jean-claudeF/LiIonCapacityMeter/KiCAD/capacity_meter_01.sch

## KiCad design KiCAD/capacity_meter_01.sch (2024-09-06)

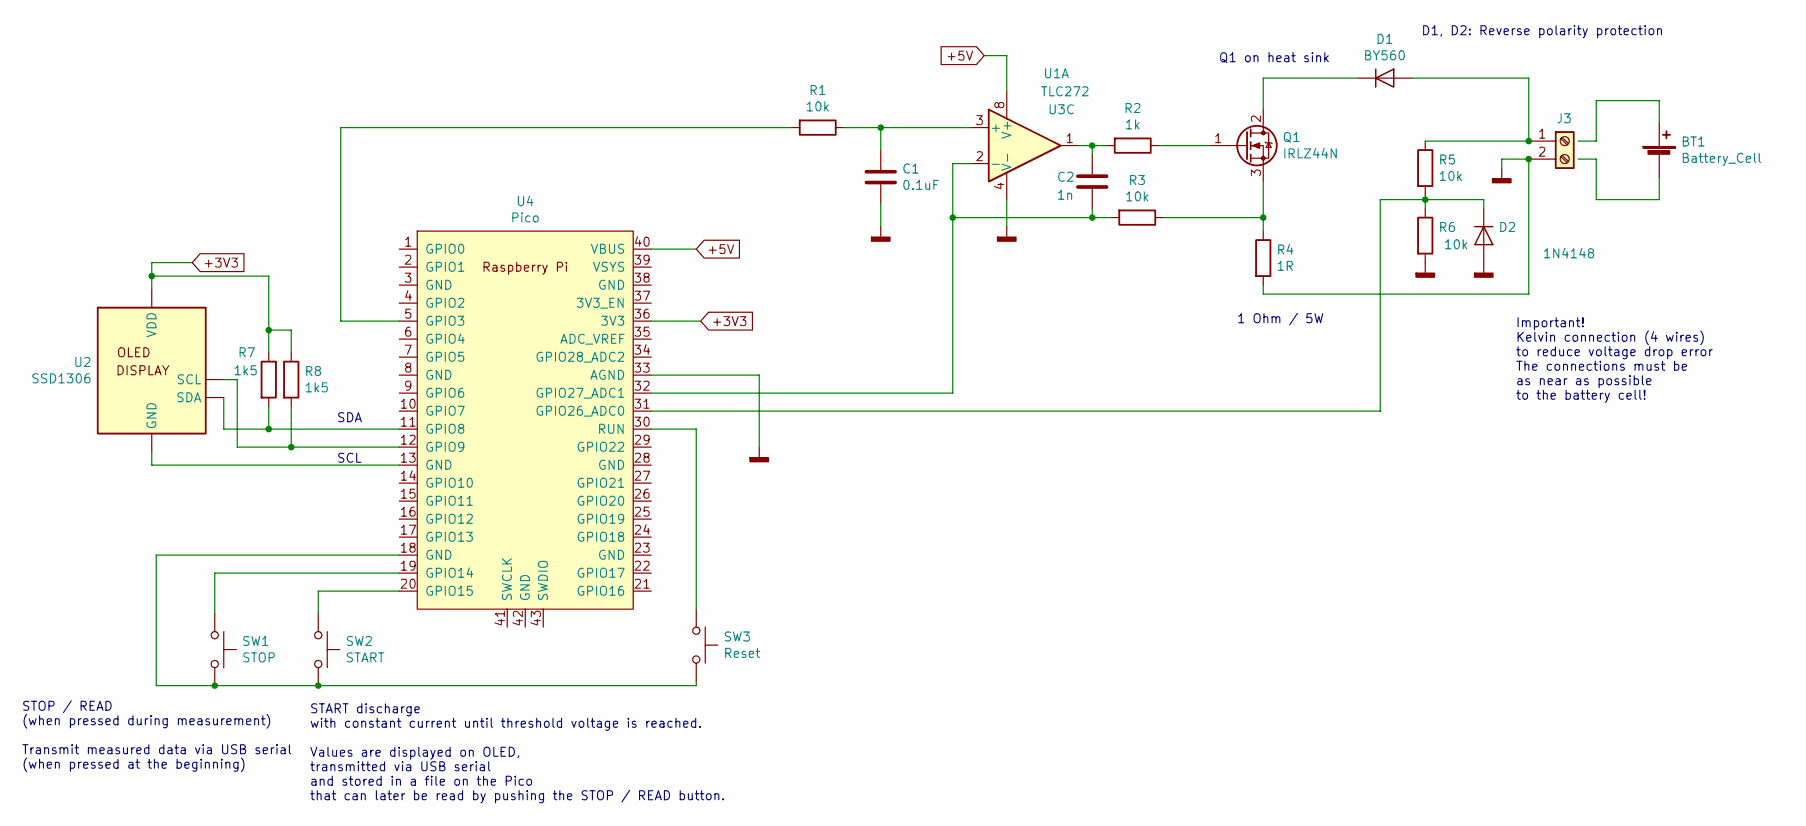
[picture p2: schematic capacity_meter_01.sch]

Parts:
BT1: Battery_Cell
C1: 0.1uF
C2: 1n
D1: BY560
D2: 1N4148
J3: (no value)
Q1: IRLZ44N
R1, R3, R5, R6: 10k
R2: 1k
R4: 1R
R7, R8: 1k5
SW1: STOP
SW2: START
SW3: Reset
U1: TLC272
U2: SSD1306
U3: (no value)
U4: Pico; RPi_Pico_SMD_TH

Connections:
+3V3: R7.1, R8.1, U2.8 (VDD), U4.36 (3V3)
+5V: U3.8 (V+), U4.40 (VBUS)
GNDD: C1.2, D2.2 (A), J3.2, R4.2, R6.2, U3.4 (V-), U4.33 (AGND)
unnamed: C1.1, R1.1, U1.3 (+)
unnamed: C2.1, R2.2, U1.1
unnamed: C2.2, R3.2, U1.2 (-), U4.32 (GPIO27_ADC1)
unnamed: D1.1 (K), Q1.2 (D)
unnamed: D1.2 (A), J3.1, R5.1
unnamed: D2.1 (K), R5.2, R6.1, U4.31 (GPIO26_ADC0)
unnamed: Q1.1 (G), R2.1
unnamed: Q1.3 (S), R3.1, R4.1
unnamed: R1.2, U4.5 (GPIO3)
unnamed: R7.2, U2.9 (SDA), U4.11 (GPIO8)
unnamed: R8.2, U2.10 (SCL), U4.12 (GPIO9)
unnamed: SW1.1, U4.19 (GPIO14)
unnamed: SW1.2, SW2.2, SW3.2, U4.18 (GND)
unnamed: SW2.1, U4.20 (GPIO15)
unnamed: SW3.1, U4.30 (RUN)
unnamed: U2.3 (GND), U4.13 (GND)

Notes on the sheet:
SDA
SCL
STOP / READ (when pressed during measurement) Transmit measured data via USB serial (when pressed at the beginning)
START discharge with constant current until threshold voltage is reached. Values are displayed on OLED, transmitted via USB serial and stored in a file on the Pico that can later be read by pushing the STOP / READ button.
Important! Kelvin connection (4 wires) to reduce voltage drop error The connections must be as near as possible to the battery cell!
1 Ohm / 5W
Q1 on heat sink
D1, D2: Reverse polarity protection
